Abhinaya-UNY/MainBoard-Transport-Unlimited2026/MainBoard_Unlimited26/MainBoard_Unlimited26B/Mobo_transport.step

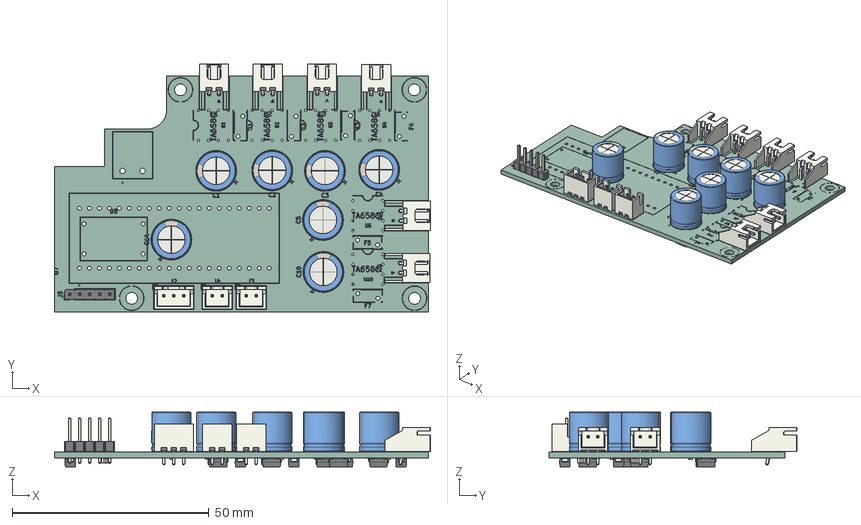
[picture p1: CAD file, 2026-08-11]
MainBoard_Unlimited26/MainBoard_Unlimited26B/Mobo_transport.step
95.6 x 63.1 x 13.9 mm
CP_Radial_D10.0mm_P5.00mm x 7
PinHeader_1x05_P2.54mm_Vertical
JST_XH_S2B-XH-A-1_1x02_P2.50mm_Horizontal x 6
JST_XH_B2B-XH-A_1x02_P2.50mm_Vertical x 2
JST_XH_B3B-XH-A_1x03_P2.50mm_Vertical
C_0805_2012Metric x 7
D_SMA x 13
MainBoard_Unlimited26B_silkscreen x 2
MainBoard_Unlimited26B_PCB
