Abhinaya-UNY/MainBoard-Transport-Unlimited2026/MainBoard_Unlimited26/MainBoard_Unlimited26B/MainBoard_Unlimited26B.pdf

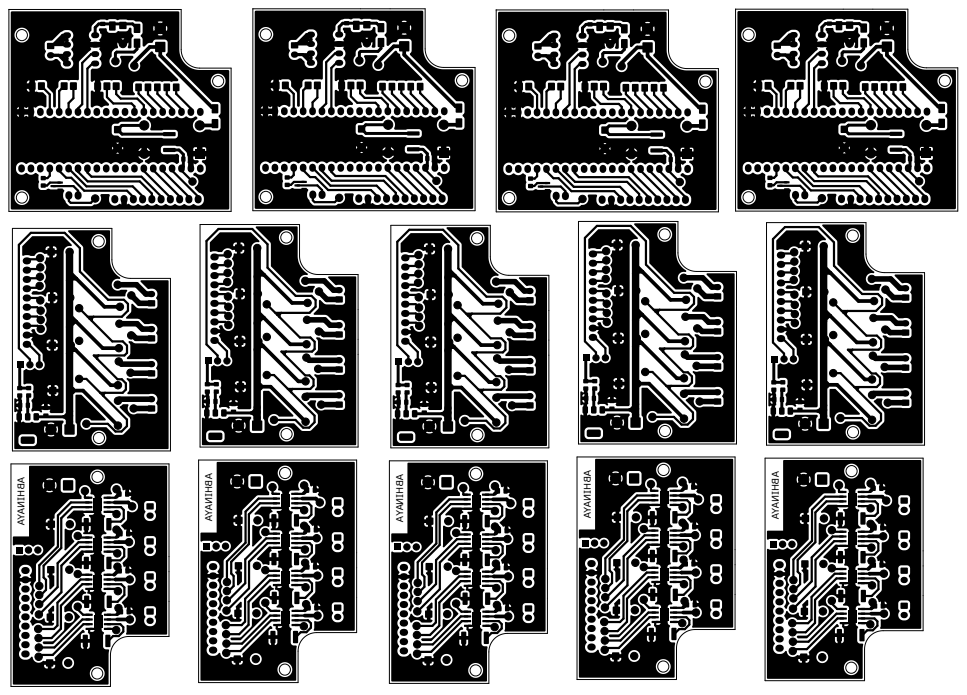
[picture p2: page 1]
ABHINAYA
