Abhinaya-UNY/MainBoard-Transport-Unlimited2026/MainBoard_Station_Unlimited26/MainBoard_Station_Unlimited26.kicad_pcb

## KiCad design MainBoard_Station_Unlimited26/MainBoard_Station_Unlimited26.kicad_pcb (2026-08-11)

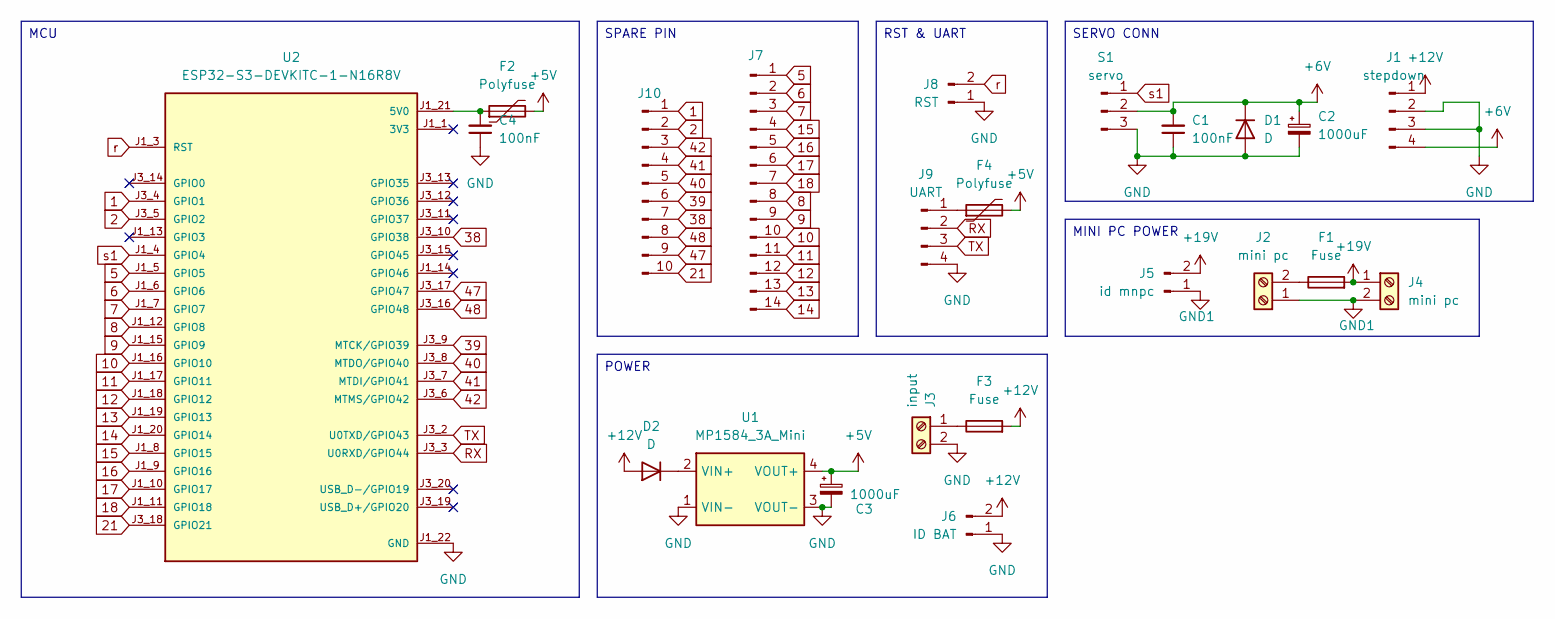
[picture p3: schematic MainBoard_Station_Unlimited26.kicad_sch]

Parts:
C1, C4: 100nF; C_0805_2012Metric_Pad1.18x1.45mm_HandSolder
C2, C3: 1000uF; CP_Radial_D10.0mm_P5.00mm
D1, D2: D; D_SMA
F1, F3: Fuse; FUSE_4628
F2, F4: Polyfuse; Fuse_1812_4532Metric
J1: stepdown; xl4015-modul
J2, J4: mini pc; TerminalBlock_MaiXu_MX126-5.0-02P_1x02_P5.00mm
J3: input; TerminalBlock_MaiXu_MX126-5.0-02P_1x02_P5.00mm
J5: id mnpc; JST_XH_B2B-XH-A_1x02_P2.50mm_Vertical
J6: ID BAT; JST_XH_B2B-XH-A_1x02_P2.50mm_Vertical
J7: Conn_01x14_Pin; PinHeader_1x14_P2.54mm_Vertical
J8: RST; JST_XH_B2B-XH-A_1x02_P2.50mm_Vertical
J9: UART; JST_XH_B4B-XH-A_1x04_P2.50mm_Vertical
J10: Conn_01x10_Pin; PinSocket_1x10_P2.54mm_Vertical
S1: servo; JST_XH_B3B-XH-A_1x03_P2.50mm_Vertical
U1: MP1584_3A_Mini; MP1584_Module
U2: ESP32-S3-DEVKITC-1-N16R8V; XCVR_ESP32-S3-DEVKITC-1-N16R8V; PARTREV 1.1

Connections:
1: J10.1, U2.J3_4 (GPIO1)
2: J10.2, U2.J3_5 (GPIO2)
5: J7.1, U2.J1_5 (GPIO5)
6: J7.2, U2.J1_6 (GPIO6)
7: J7.3, U2.J1_7 (GPIO7)
8: J7.8, U2.J1_12 (GPIO8)
9: J7.9, U2.J1_15 (GPIO9)
10: J7.10, U2.J1_16 (GPIO10)
11: J7.11, U2.J1_17 (GPIO11)
12: J7.12, U2.J1_18 (GPIO12)
13: J7.13, U2.J1_19 (GPIO13)
14: J7.14, U2.J1_20 (GPIO14)
15: J7.4, U2.J1_8 (GPIO15)
16: J7.5, U2.J1_9 (GPIO16)
17: J7.6, U2.J1_10 (GPIO17)
18: J7.7, U2.J1_11 (GPIO18)
21: J10.10, U2.J3_18 (GPIO21)
38: J10.7, U2.J3_10 (GPIO38)
39: J10.6, U2.J3_9 (MTCK/GPIO39)
40: J10.5, U2.J3_8 (MTDO/GPIO40)
41: J10.4, U2.J3_7 (MTDI/GPIO41)
42: J10.3, U2.J3_6 (MTMS/GPIO42)
47: J10.9, U2.J3_17 (GPIO47)
48: J10.8, U2.J3_16 (GPIO48)
+5V: C3.1, F2.2, F4.2, U1.4 (VOUT+)
+6V: C1.2, C2.1, D1.1 (K), J1.4, S1.2
+12V: D2.2 (A), F3.2, J1.1, J6.2
GND: C1.1, C2.2, C3.2, C4.1, D1.2 (A), J1.2, J1.3, J3.2, J6.1, J8.1, J9.4, S1.3, U1.1 (VIN-), U1.3 (VOUT-), U2.J1_22 (GND), U2.J3_1 (GND), U2.J3_21 (GND), U2.J3_22 (GND)
GND1: J2.1, J4.2, J5.1
unnamed: D2.1 (K), U1.2 (VIN+)
unnamed: F1.1, J2.2
unnamed: F3.1, J3.1
unnamed: F1.2, J4.1, J5.2
unnamed: F4.1, J9.1
unnamed: C4.2, F2.1, U2.J1_21 (5V0)
RX: J9.2, U2.J3_3 (U0RXD/GPIO44)
TX: J9.3, U2.J3_2 (U0TXD/GPIO43)
s1: S1.1, U2.J1_4 (GPIO4)

Notes on the sheet:
POWER
MINI PC POWER
MCU
SPARE PIN
RST & UART
SERVO CONN

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
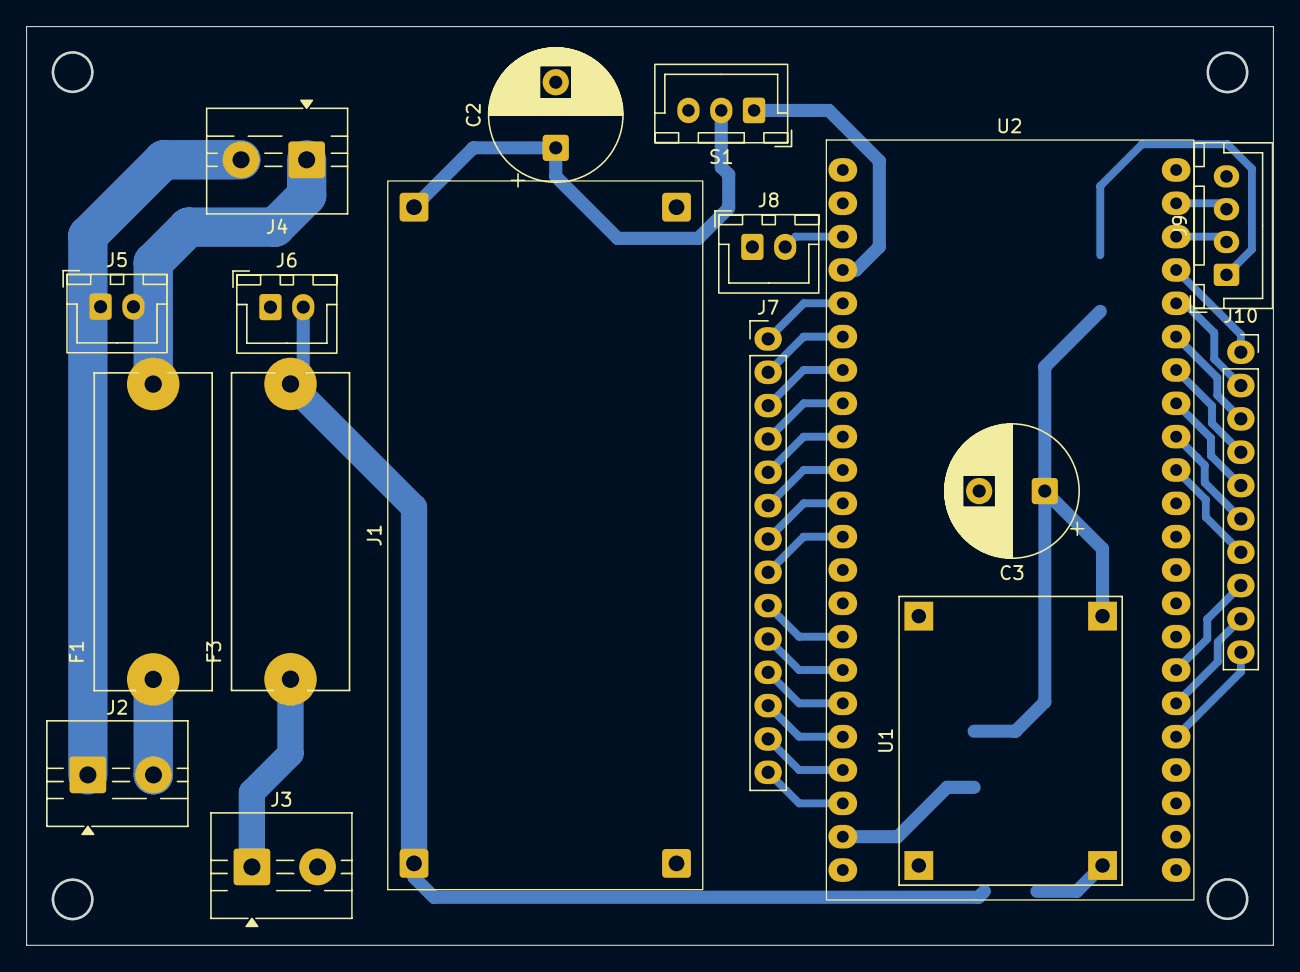
[picture p4: board MainBoard_Station_Unlimited26.kicad_pcb from above]

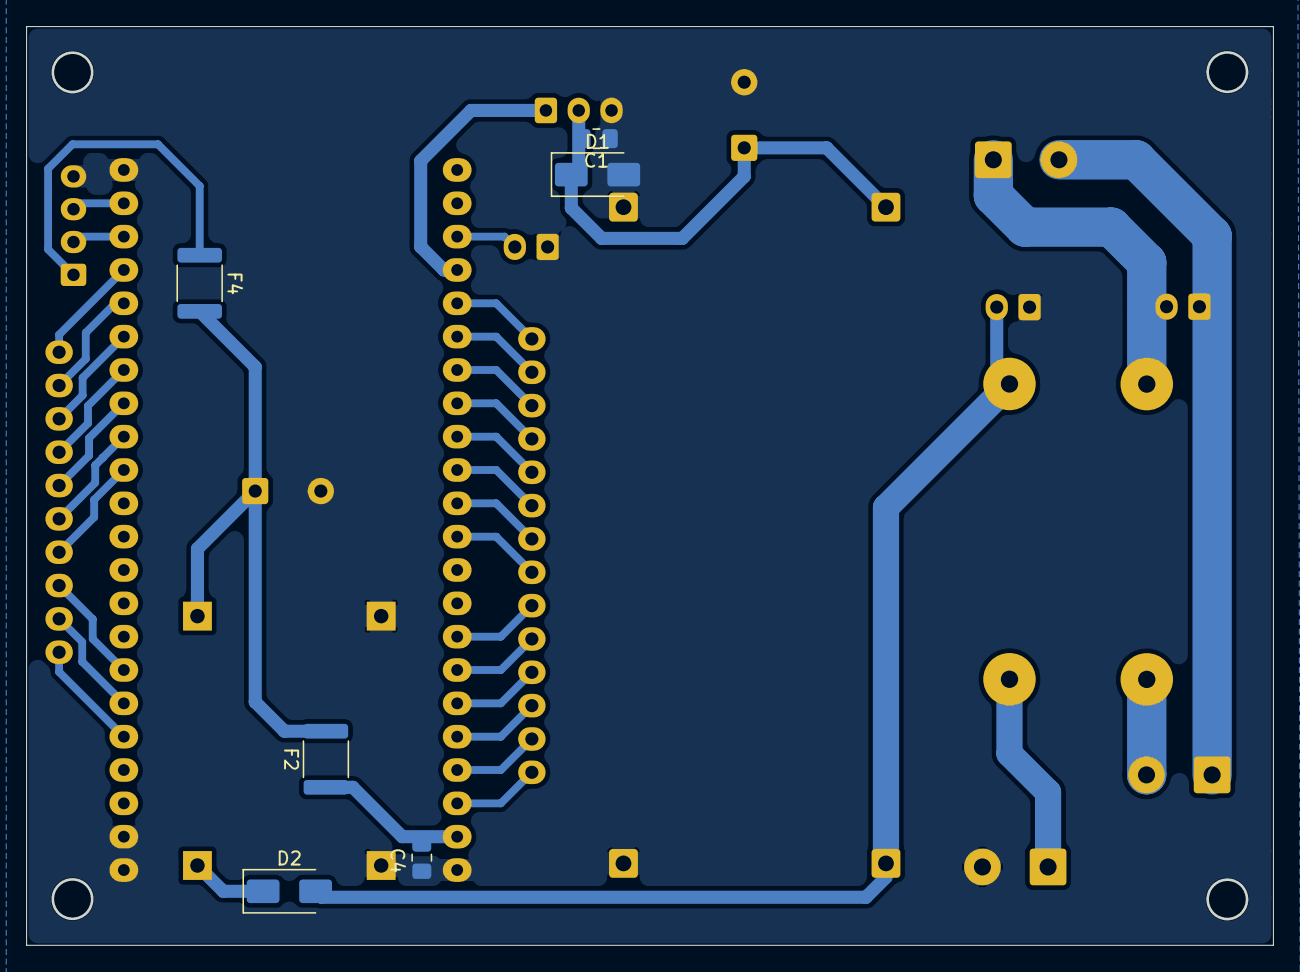
[picture p5: board MainBoard_Station_Unlimited26.kicad_pcb from below]

Board: 2 copper layers, 95.0 x 70.0 mm, 23 parts (6 on the bottom side), 38 nets.
