Abhinaya-UNY/MainBoard-Transport-Unlimited2026/MainBoard_Unlimited26/MainBoard_Unlimited26A/MainBoard_Unlimited26A.kicad_pcb

## KiCad design MainBoard_Unlimited26/MainBoard_Unlimited26A/MainBoard_Unlimited26A.kicad_pcb (2026-08-11)

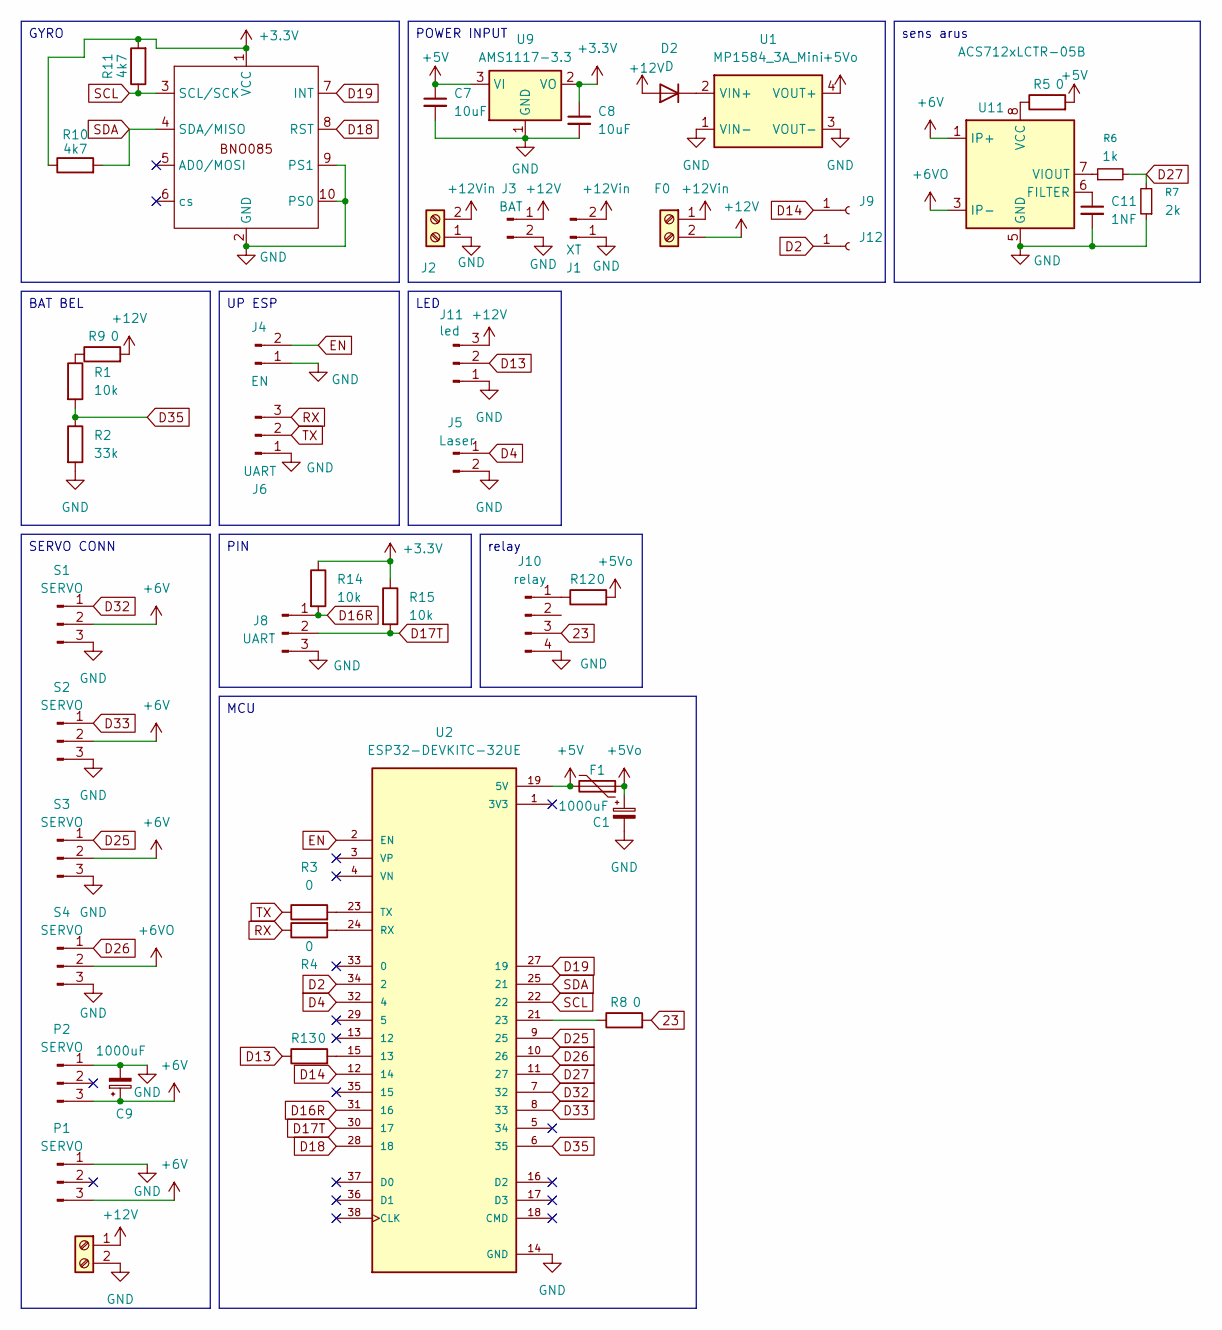
[picture p6: schematic MainBoard_Unlimited26A.kicad_sch]

Parts:
C1, C9: 1000uF; CP_Radial_D10.0mm_P5.00mm
C7, C8: 10uF; C_0805_2012Metric_Pad1.18x1.45mm_HandSolder
C11: 1NF; C_0805_2012Metric_Pad1.18x1.45mm_HandSolder
D2: D; D_SMA
F0: Screw_Terminal_01x02; TerminalBlock_MaiXu_MX126-5.0-02P_1x02_P5.00mm
F1: Polyfuse; Fuse_1812_4532Metric
J1: XT; AMASS_XT30U-F_1x02_P5.0mm_Vertical
J2: Screw_Terminal_01x02; TerminalBlock_MaiXu_MX126-5.0-02P_1x02_P5.00mm
J3: BAT; JST_XH_B2B-XH-A_1x02_P2.50mm_Vertical
J4: EN; PinHeader_1x02_P2.54mm_Vertical
J5: Laser; JST_XH_B2B-XH-A_1x02_P2.50mm_Vertical
J6: UART; JST_XH_S3B-XH-A_1x03_P2.50mm_Horizontal
J8: UART; JST_XH_S3B-XH-A-1_1x03_P2.50mm_Horizontal
J9, J12: Conn_01x01_Socket; PinHeader_1x01_P2.54mm_Vertical
J10: relay; JST_XH_B4B-XH-A_1x04_P2.50mm_Vertical
J11: led; JST_XH_B3B-XH-A_1x03_P2.50mm_Vertical
P1, P2: SERVO; JST_XH_B3B-XH-A_1x03_P2.50mm_Vertical
R1: 10k; R_1206_3216Metric_Pad1.30x1.75mm_HandSolder
R2: 33k; R_0805_2012Metric_Pad1.20x1.40mm_HandSolder
R3, R4, R5, R8, R9, R12, R13: 0; R_1206_3216Metric_Pad1.30x1.75mm_HandSolder
R6: 1k; R_0805_2012Metric_Pad1.20x1.40mm_HandSolder
R7: 2k; R_0805_2012Metric_Pad1.20x1.40mm_HandSolder
R10, R11: 4k7; R_0805_2012Metric_Pad1.20x1.40mm_HandSolder
R14, R15: 10k; R_0805_2012Metric_Pad1.20x1.40mm_HandSolder
S0: Screw_Terminal_01x02; TerminalBlock_MaiXu_MX126-5.0-02P_1x02_P5.00mm
S1, S2, S3, S4: SERVO; JST_XH_B3B-XH-A_1x03_P2.50mm_Vertical
U1: MP1584_3A_Mini; MP1584_Module
U2: ESP32-DEVKITC-32UE; ESPRESSIF_ESP32-DEVKITC-32UE; PARTREV V4
U8: MPU6050/BNO085 I2C; PinSocket_1x10_P2.54mm_Vertical
U9: AMS1117-3.3; SOT-223-3_TabPin2
U11: ACS712xLCTR-05B; SOIC-8_3.9x4.9mm_P1.27mm

Connections:
23: J10.3, R8.2
+3.3V: C8.1, R10.1, R11.2, R14.1, R15.1, U8.1 (VCC), U9.2 (VO)
+5V: C7.1, F1.2, R5.2, U2.19 (5V), U9.3 (VI)
+5Vo: C1.1, F1.1, R12.2, U1.4 (VOUT+)
+6V: C9.1, P1.3, P2.3, S1.2, S2.2, S3.2, U11.1 (IP+), U11.2 (IP+)
+6VO: S4.2, U11.3 (IP-), U11.4 (IP-)
+12V: D2.2 (A), F0.2, J3.1, J11.3, R9.2, S0.1
+12Vin: F0.1, J1.2, J2.2
D2: J12.1 (Pin_1_1), U2.34 (2)
D4: J5.1, U2.32 (4)
D13: J11.2, R13.1
D14: J9.1 (Pin_1_1), U2.12 (14)
D16R: J8.1, R14.2, U2.31 (16)
D17T: J8.2, R15.2, U2.30 (17)
D18: U2.28 (18), U8.8 (RST)
D19: U2.27 (19), U8.7 (INT)
D25: S3.1, U2.9 (25)
D26: S4.1, U2.10 (26)
D27: R6.2, R7.2, U2.11 (27)
D32: S1.1, U2.7 (32)
D33: S2.1, U2.8 (33)
D35: R1.2, R2.1, U2.6 (35)
EN: J4.2, U2.2 (EN)
GND: C1.2, C7.2, C8.2, C9.2, C11.2, J1.1, J2.1, J3.2, J4.1, J5.2, J6.1, J8.3, J10.4, J11.1, P1.1, P2.1, R2.2, R7.1, S0.2, S1.3, S2.3, S3.3, S4.3, U1.1 (VIN-), U1.3 (VOUT-), U2.14 (GND), U2.20 (GND), U2.26 (GND), U8.2 (GND), U8.9 (PS1), U8.10 (PS0), U9.1 (GND), U11.5 (GND)
unnamed: D2.1 (K), U1.2 (VIN+)
unnamed: J10.1, R12.1
unnamed: R1.1, R9.1
unnamed: R13.2, U2.15 (13)
unnamed: R8.1, U2.21 (23)
unnamed: R4.2, U2.24 (RX)
unnamed: R3.2, U2.23 (TX)
unnamed: C11.1, U11.6 (FILTER)
unnamed: R5.1, U11.8 (VCC)
unnamed: R6.1, U11.7 (VIOUT)
RX: J6.3, R4.1
SCL: R11.1, U2.22, U8.3 (SCL/SCK)
SDA: R10.2, U2.25 (21), U8.4 (SDA/MISO)
TX: J6.2, R3.1

Notes on the sheet:
PIN
UP ESP
sens arus
POWER INPUT
MCU
BAT BEL
GYRO
LED
SERVO CONN
relay

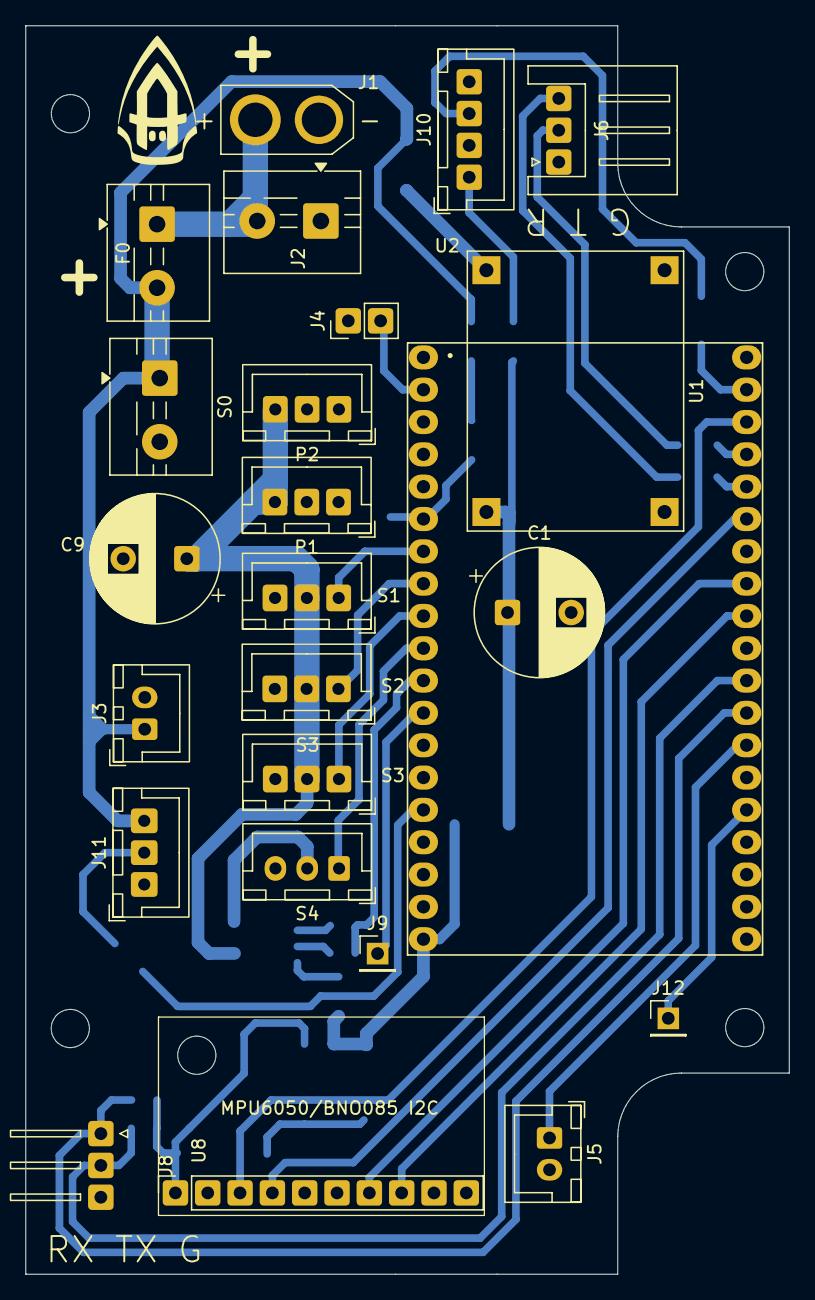
[picture p7: board MainBoard_Unlimited26A.kicad_pcb from above]

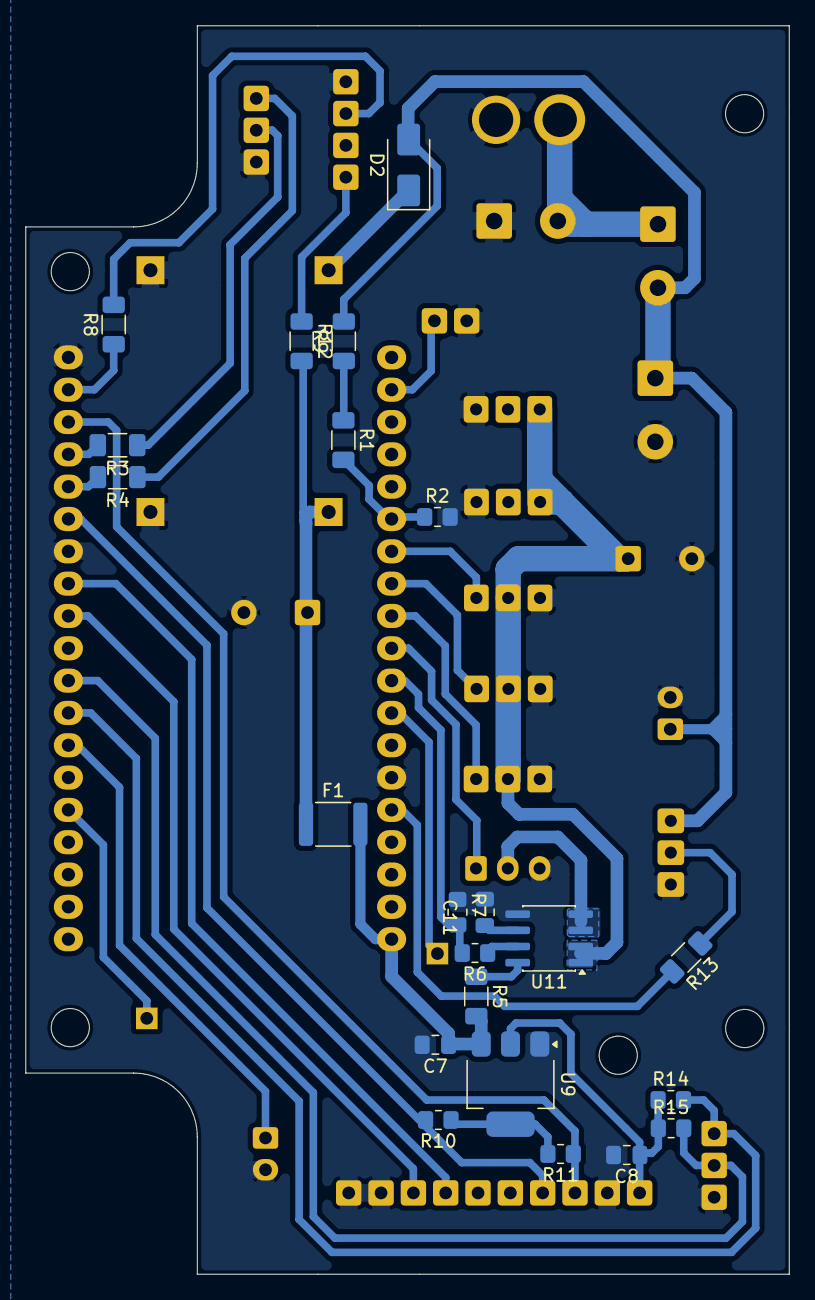
[picture p8: board MainBoard_Unlimited26A.kicad_pcb from below]

Board: 2 copper layers, 60.0 x 98.1 mm, 46 parts (22 on the bottom side), 38 nets.
