Abhinaya-UNY/MainBoard-Transport-Unlimited2026/esp32-cam_holder/esp32-cam_holder.kicad_pcb

## KiCad design esp32-cam_holder/esp32-cam_holder.kicad_pcb (2026-08-11)

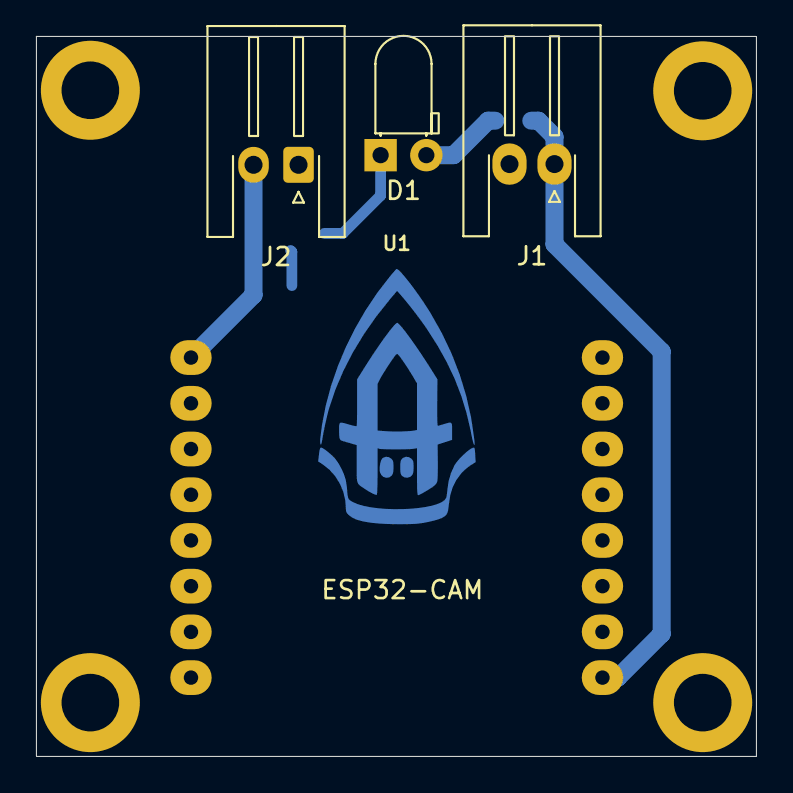
[picture p9: board esp32-cam_holder.kicad_pcb from above]

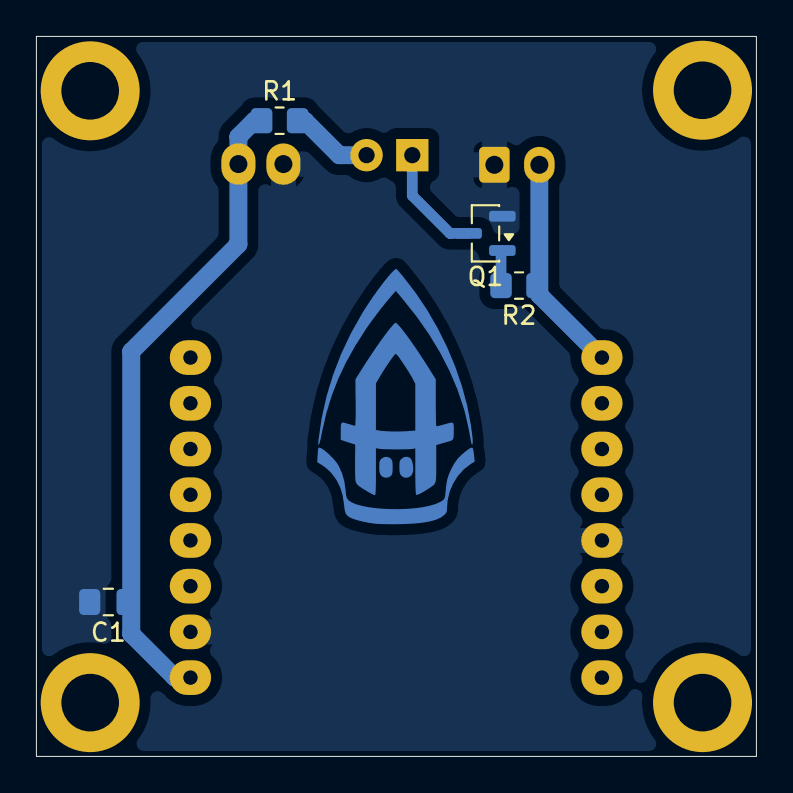
[picture p10: board esp32-cam_holder.kicad_pcb from below]

Board: 2 copper layers, 40.0 x 40.0 mm, 8 parts (4 on the bottom side), 6 nets.

Parts:
C1: 100nF; C_0805_2012Metric_Pad1.18x1.45mm_HandSolder
D1: LED; LED_D3.0mm_Horizontal_O1.27mm_Z6.0mm
J1: power; JST_XH_S2B-XH-A-1_1x02_P2.50mm_Horizontal
J2: RST; JST_XH_S2B-XH-A-1_1x02_P2.50mm_Horizontal
Q1: MMBT3904; SOT-23
R1: 220; R_0805_2012Metric_Pad1.20x1.40mm_HandSolder
R2: 1k; R_0805_2012Metric_Pad1.20x1.40mm_HandSolder
U1: ESP32-CAM

Connections:
+5V: C1.1, J1.1, R1.1, U1.5V
GND: C1.2, J1.2, J2.1, Q1.2 (E), U1.GND, U1.GND2
unnamed: D1.2 (A), R1.2
unnamed: D1.1 (K), Q1.3 (C)
unnamed: Q1.1 (B), R2.2
RST: J2.2, R2.1, U1.GND1
