Abhinaya-UNY/MainBoard-Transport-Unlimited2026/MainBoard_Unlimited26/MainBoard_Unlimited26B/MainBoard_Unlimited26B.kicad_pcb

## KiCad design MainBoard_Unlimited26/MainBoard_Unlimited26B/MainBoard_Unlimited26B.kicad_pcb (2026-08-11)

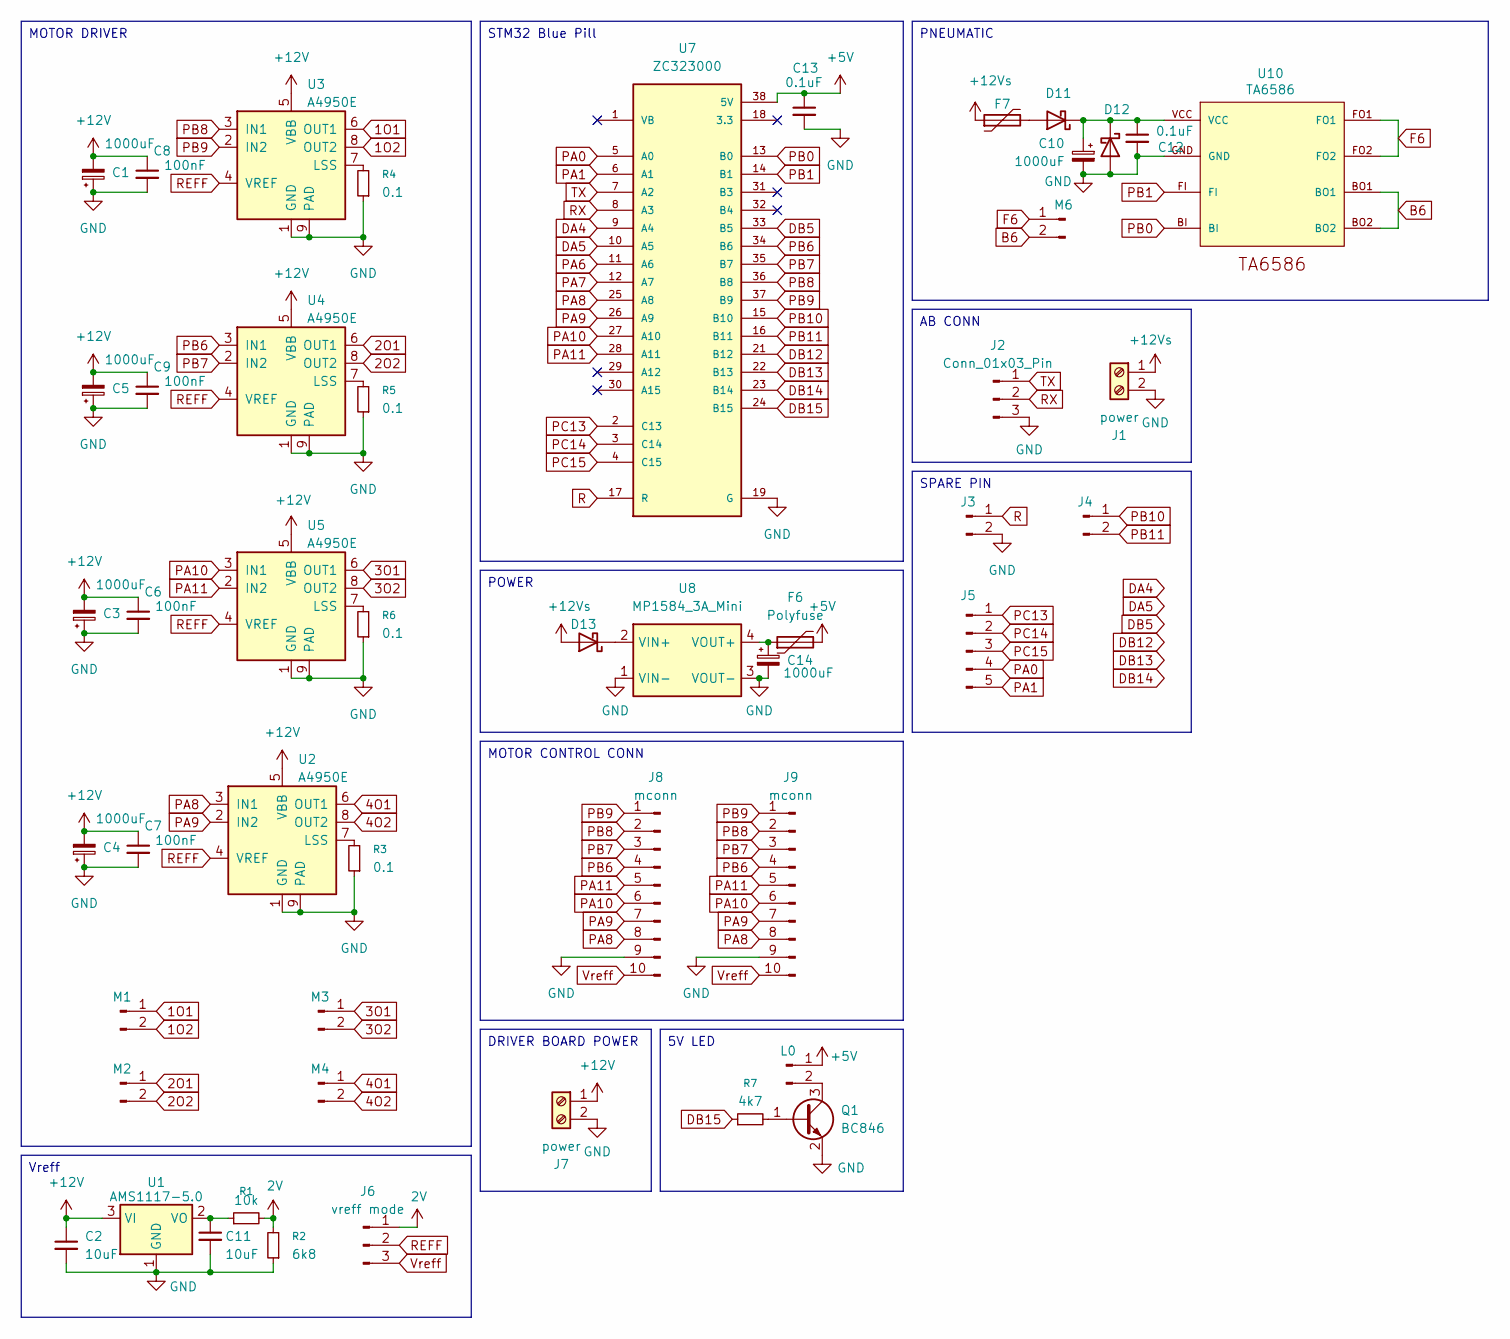
[picture p11: schematic MainBoard_Unlimited26B.kicad_sch]

Parts:
C1, C3, C4, C5, C10, C14: 1000uF; CP_Radial_D10.0mm_P5.00mm
C2, C11: 10uF; C_0805_2012Metric_Pad1.18x1.45mm_HandSolder
C6, C7, C8, C9: 100nF; C_0805_2012Metric_Pad1.18x1.45mm_HandSolder
C12, C13: 0.1uF; C_0805_2012Metric_Pad1.18x1.45mm_HandSolder
D11, D12, D13: D_Schottky; D_SMA
F6: Polyfuse; Fuse_1812_4532Metric
F7: Polyfuse; Fuse_Bourns_MF-RG300
J1, J7: power; TerminalBlock_MaiXu_MX126-5.0-02P_1x02_P5.00mm
J2: Conn_01x03_Pin; JST_XH_B3B-XH-A_1x03_P2.50mm_Vertical
J3, J4: JST_XH_B2B-XH-A_1x02_P2.50mm_Vertical
J5: Conn_01x05_Pin; PinHeader_1x05_P2.54mm_Vertical
J6: vreff mode; PinHeader_1x03_P2.54mm_Vertical
J8, J9: mconn; JST_XH_B10B-XH-A_1x10_P2.50mm_Vertical
L0: JST_XH_B2B-XH-A_1x02_P2.50mm_Vertical
M1, M2, M3, M4, M6: JST_XH_B2B-XH-A_1x02_P2.50mm_Vertical
Q1: BC846; SOT-23
R1: 10k; R_0805_2012Metric_Pad1.20x1.40mm_HandSolder
R2: 6k8; R_0805_2012Metric_Pad1.20x1.40mm_HandSolder
R3, R4, R5, R6: 0.1; R_2512_6332Metric_Pad1.40x3.35mm_HandSolder
R7: 4k7; R_0805_2012Metric_Pad1.20x1.40mm_HandSolder
U1: AMS1117-5.0; SOT-223-3_TabPin2
U2, U3, U4, U5: A4950E; SOIC-8-1EP_3.9x4.9mm_P1.27mm_EP2.41x3.3mm
U7: ZC323000; MODULE_ZC323000; PARTREV N/A
U8: MP1584_3A_Mini; Mini360
U10: TA6586; TA6586-FOOTPRINT

Connections:
1O1: M1.1, U3.6 (OUT1)
1O2: M1.2, U3.8 (OUT2)
2O1: M2.1, U4.6 (OUT1)
2O2: M2.2, U4.8 (OUT2)
2V: J6.1, R1.2, R2.2
3O1: M3.1, U5.6 (OUT1)
3O2: M3.2, U5.8 (OUT2)
4O1: M4.1, U2.6 (OUT1)
4O2: M4.2, U2.8 (OUT2)
+5V: C13.1, F6.2, L0.1, U7.38 (5V)
+12V: C1.2, C2.1, C3.2, C4.2, C5.2, C6.1, C7.1, C8.1, C9.1, J7.1, U1.3 (VI), U2.5 (VBB), U3.5 (VBB), U4.5 (VBB), U5.5 (VBB)
+12Vs: D13.2 (A), F7.1, J1.1
B6: M6.2, U10.BO1, U10.BO2
DA4: U7.9 (A4)
DA5: U7.10 (A5)
DB5: U7.33 (B5)
DB12: U7.21 (B12)
DB13: U7.22 (B13)
DB14: U7.23 (B14)
DB15: R7.1, U7.24 (B15)
F6: M6.1, U10.FO1, U10.FO2
GND: C1.1, C2.2, C3.1, C4.1, C5.1, C6.2, C7.2, C8.2, C9.2, C10.2, C11.2, C12.2, C13.2, C14.2, D12.2 (A), J1.2, J2.3, J3.2, J7.2, J8.9, J9.9, Q1.2 (E), R2.1, R3.1, R4.1, R5.1, R6.1, U1.1 (GND), U2.1 (GND), U2.9 (PAD), U3.1 (GND), U3.9 (PAD), U4.1 (GND), U4.9 (PAD), U5.1 (GND), U5.9 (PAD), U7.19 (G), U7.20 (G), U7.39 (G), U8.1 (VIN-), U8.3 (VOUT-), U10.GND
unnamed: D11.2 (A), F7.2
unnamed: C10.1, C12.1, D11.1 (K), D12.1 (K), U10.VCC
unnamed: D13.1 (K), U8.2 (VIN+)
unnamed: L0.2, Q1.3 (C)
unnamed: Q1.1 (B), R7.2
unnamed: C11.1, R1.1, U1.2 (VO)
unnamed: R3.2, U2.7 (LSS)
unnamed: R4.2, U3.7 (LSS)
unnamed: R5.2, U4.7 (LSS)
unnamed: R6.2, U5.7 (LSS)
unnamed: C14.1, F6.1, U8.4 (VOUT+)
PA0: J5.4, U7.5 (A0)
PA1: J5.5, U7.6 (A1)
PA6: U7.11 (A6)
PA7: U7.12 (A7)
PA8: J8.8, J9.8, U2.3 (IN1), U7.25 (A8)
PA9: J8.7, J9.7, U2.2 (IN2), U7.26 (A9)
PA10: J8.6, J9.6, U5.3 (IN1), U7.27 (A10)
PA11: J8.5, J9.5, U5.2 (IN2), U7.28 (A11)
PB0: U7.13 (B0), U10.BI
PB1: U7.14 (B1), U10.FI
PB6: J8.4, J9.4, U4.3 (IN1), U7.34 (B6)
PB7: J8.3, J9.3, U4.2 (IN2), U7.35 (B7)
PB8: J8.2, J9.2, U3.3 (IN1), U7.36 (B8)
PB9: J8.1, J9.1, U3.2 (IN2), U7.37 (B9)
PB10: J4.1, U7.15 (B10)
PB11: J4.2, U7.16 (B11)
PC13: J5.1, U7.2 (C13)
PC14: J5.2, U7.3 (C14)
PC15: J5.3, U7.4 (C15)
R: J3.1, U7.17 (R)
REFF: J6.2, U2.4 (VREF), U3.4 (VREF), U4.4 (VREF), U5.4 (VREF)
RX: J2.2, U7.8 (A3)
TX: J2.1, U7.7 (A2)
Vreff: J6.3, J8.10, J9.10

Notes on the sheet:
MOTOR CONTROL CONN
POWER
DRIVER BOARD POWER
PNEUMATIC
Vreff
AB CONN
5V LED
STM32 Blue Pill
SPARE PIN
MOTOR DRIVER

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
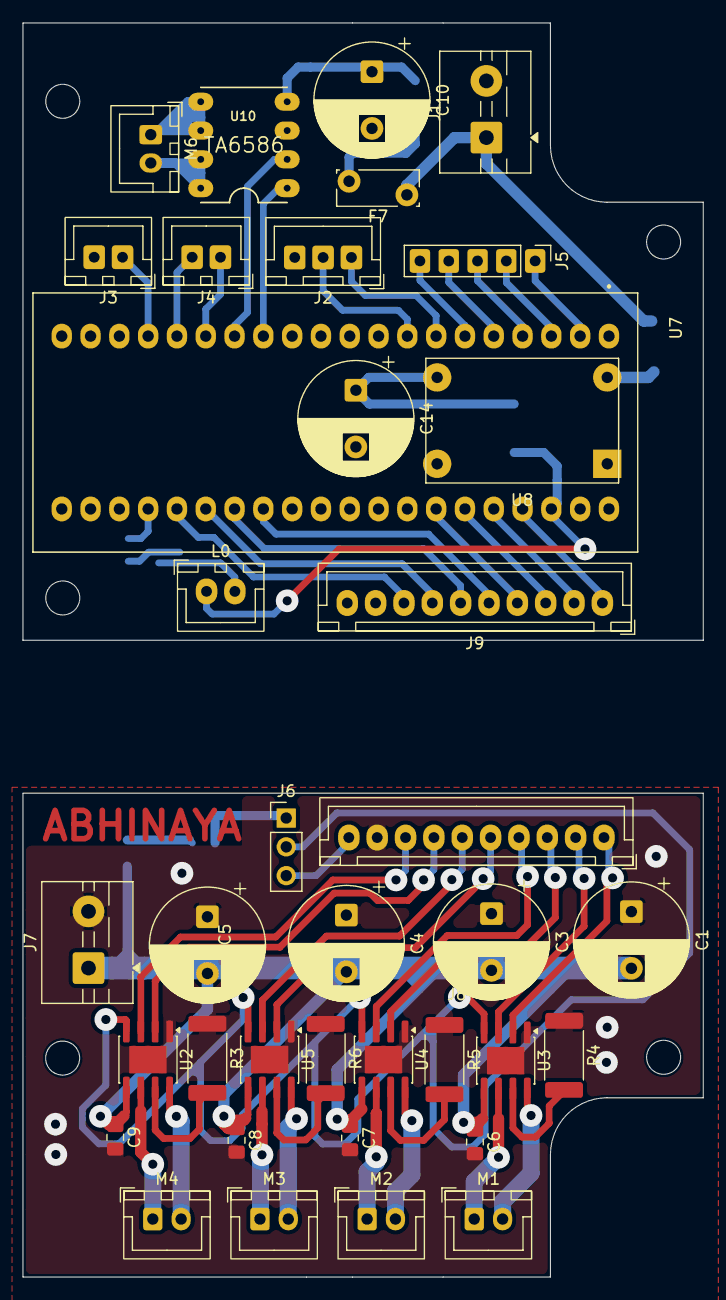
[picture p12: board MainBoard_Unlimited26B.kicad_pcb from above]

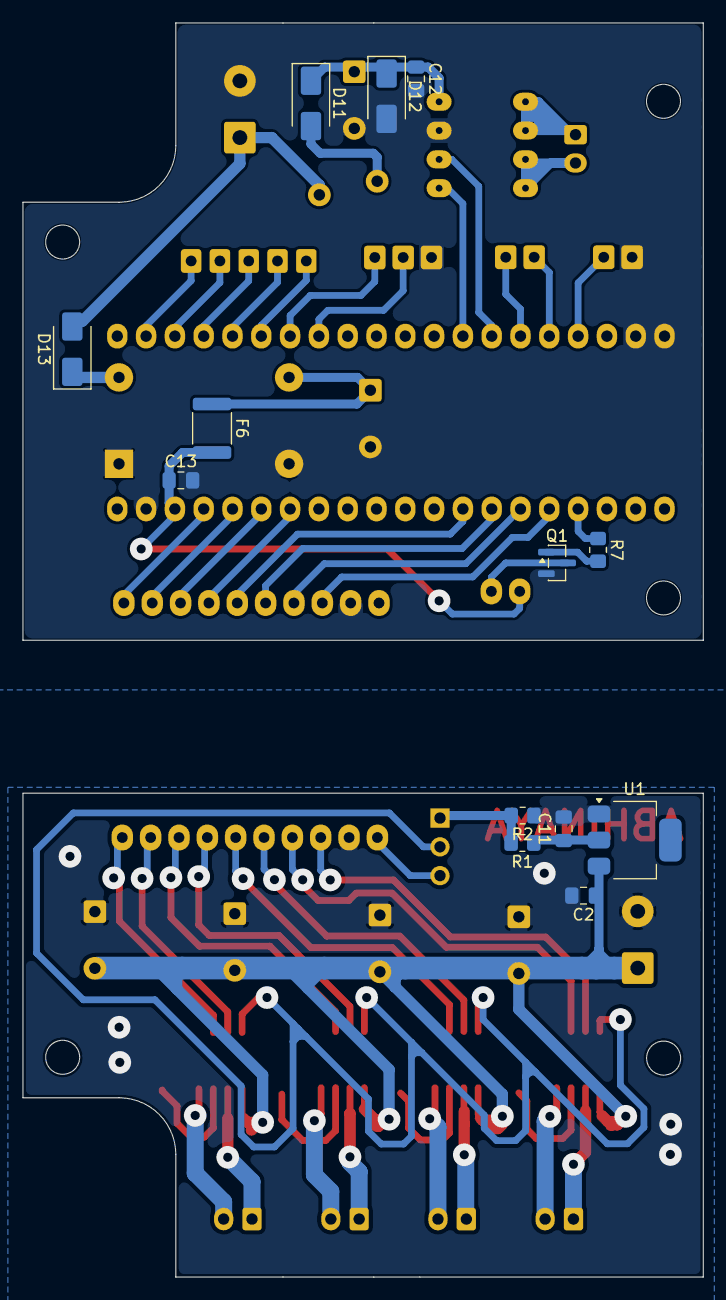
[picture p13: board MainBoard_Unlimited26B.kicad_pcb from below]

Board: 2 copper layers, 60.0 x 110.6 mm, 50 parts (13 on the bottom side), 49 nets.
