Abhinaya-UNY/MainBoard-Transport-Unlimited2026/(commit log)

2026-08-04 Update Pin Robot Transporter.md
2026-08-11 REV ALL
    [MainBoard_Station_Unlimited26.kicad_pcb, MainBoard_Station_Unlimited26.kicad_sch, MainBoard_Unlimited26A.kicad_pcb, MainBoard_Unlimited26A.kicad_sch, MainBoard_Unlimited26B.kicad_pcb, MainBoard_Unlimited26B.kicad_sch, Mobo_transport.step, esp32-cam_holder.kicad_pcb]
